BOJIT/squishbox-zero/README.md

# squishbox-zero
MIDI Synthesiser based on https://github.com/GeekFunkLabs/squishbox: adapted for Pi Zero 2W
