BOJIT/squishbox-zero/hardware/squishbox_zero.kicad_pcb

## KiCad design hardware/squishbox_zero.kicad_pcb (2025-08-31)

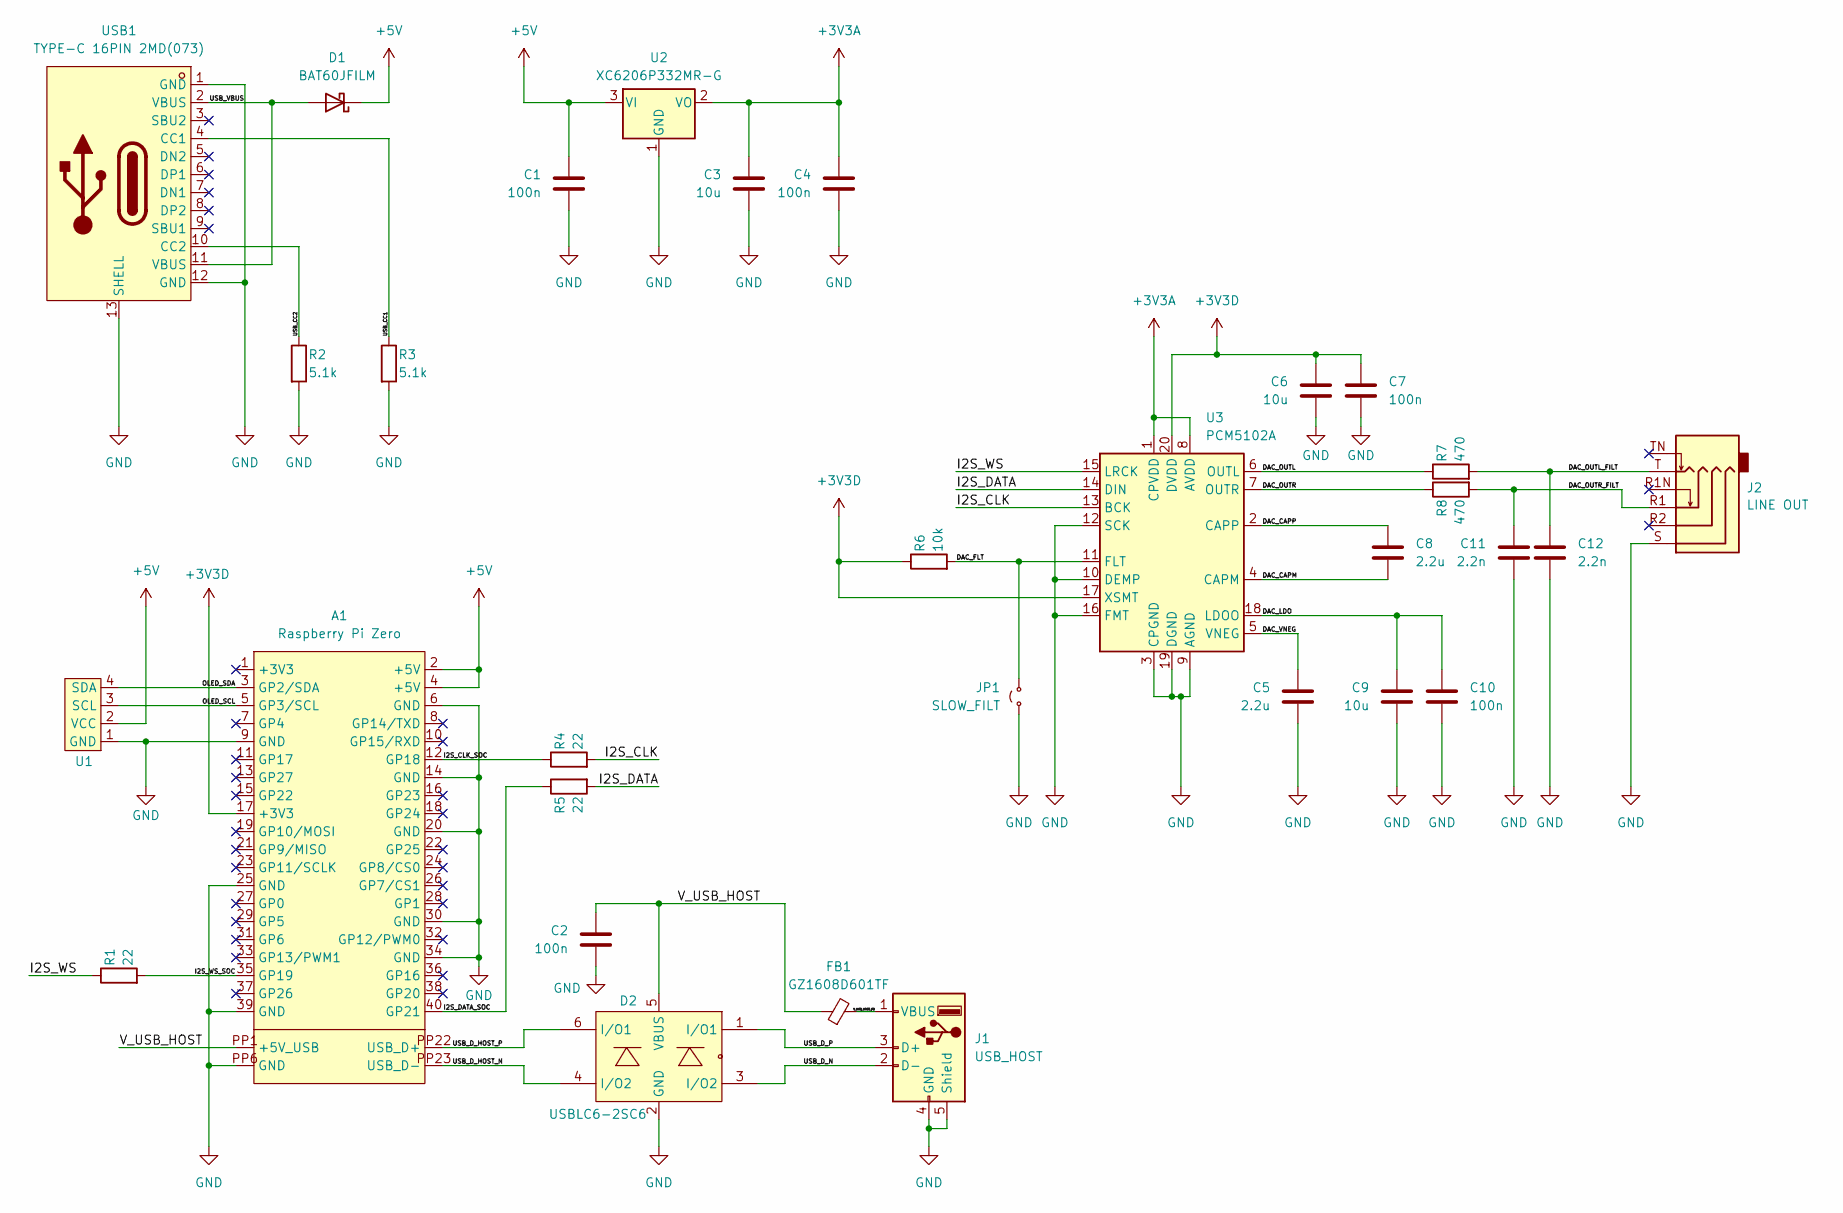
[picture p1: schematic squishbox_zero.kicad_sch]

Parts:
A1: Raspberry Pi Zero; Raspberry_Pi_Zero
C1, C2, C4, C7, C10: 100n; C_0402_1005Metric; LCSC Part C1525
C3, C6, C9: 10u; C_0603_1608Metric; LCSC Part C19702
C5, C8: 2.2u; C_0402_1005Metric; LCSC Part C12530
C11, C12: 2.2n; C_0805_2012Metric; LCSC Part C28260
D1: BAT60JFILM; D_SOD-323; LCSC Part C133103
D2: USBLC6-2SC6; SOT-23-6_L2.9-W1.6-P0.95-LS2.8-BL; LCSC Part C7519
FB1: GZ1608D601TF; R_0603_1608Metric; LCSC Part C1002
J1: USB_HOST; USB-A-SMD_USB-M-21; LCSC Part C42474
J2: LINE OUT; AUDIO-SMD_PJ-342; LCSC Part C668606
JP1: SLOW_FILT; SolderJumper-2_P1.3mm_Open_RoundedPad1.0x1.5mm
R1, R4, R5: 22; R_0402_1005Metric; LCSC Part C25092
R2, R3: 5.1k; R_0402_1005Metric; LCSC Part C25905
R6: 10k; R_0402_1005Metric; LCSC Part C25744
R7, R8: 470; R_0402_1005Metric; LCSC Part C25117
U1: SSD1306-0.91-OLED-4pin-128x32
U2: XC6206P332MR-G; SOT-23-3; LCSC Part C5446
U3: PCM5102A; TSSOP-20_4.4x6.5mm_P0.65mm; LCSC Part C107671
USB1: TYPE-C 16PIN 2MD(073); USB-C-SMD_TYPE-C-16PIN; LCSC Part C2765186

Connections:
+3V3A: C3.1, C4.1, U2.2 (VO), U3.1 (CPVDD), U3.8 (AVDD)
+3V3D: A1.17 (+3V3), C6.1, C7.1, R6.1, U3.17 (XSMT), U3.20 (DVDD)
+5V: A1.2 (+5V), A1.4 (+5V), C1.1, D1.1 (K), U1.2 (VCC), U2.3 (VI)
/DAC_CAPM: C8.2, U3.4 (CAPM)
/DAC_CAPP: C8.1, U3.2 (CAPP)
/DAC_FLT: JP1.2 (B), R6.2, U3.11 (FLT)
/DAC_LDO: C9.1, C10.1, U3.18 (LDOO)
/DAC_OUTL: R7.1, U3.6 (OUTL)
/DAC_OUTL_FILT: C12.1, J2.T, R7.2
/DAC_OUTR: R8.1, U3.7 (OUTR)
/DAC_OUTR_FILT: C11.1, J2.R1, R8.2
/DAC_VNEG: C5.1, U3.5 (VNEG)
/I2S_CLK: R4.2, U3.13 (BCK)
/I2S_CLK_SOC: A1.12 (GP18), R4.1
/I2S_DATA: R5.2, U3.14 (DIN)
/I2S_DATA_SOC: A1.40 (GP21), R5.1
/I2S_WS: R1.1, U3.15 (LRCK)
/I2S_WS_SOC: A1.35 (GP19), R1.2
/OLED_SCL: A1.5 (GP3/SCL), U1.3 (SCL)
/OLED_SDA: A1.3 (GP2/SDA), U1.4 (SDA)
/USB_CC1: R3.1, USB1.4 (CC1)
/USB_CC2: R2.1, USB1.10 (CC2)
/USB_D_HOST_N: A1.PP23 (USB_D-), D2.4 (I/O2)
/USB_D_HOST_P: A1.PP22 (USB_D+), D2.6 (I/O1)
/USB_D_N: D2.3 (I/O2), J1.2 (D-)
/USB_D_P: D2.1 (I/O1), J1.3 (D+)
/USB_VBUS: D1.2 (A), USB1.2 (VBUS), USB1.11 (VBUS)
/V_USB_HOST: A1.PP1 (+5V_USB), C2.1, D2.5 (VBUS), FB1.1
/V_USB_HOST_FB: FB1.2, J1.1 (VBUS)
GND: A1.6 (GND), A1.9 (GND), A1.14 (GND), A1.20 (GND), A1.25 (GND), A1.30 (GND), A1.34 (GND), A1.39 (GND), A1.PP6 (GND), C1.2, C2.2, C3.2, C4.2, C5.2, C6.2, C7.2, C9.2, C10.2, C11.2, C12.2, D2.2 (GND), J1.4 (GND), J1.5 (Shield), J2.S, JP1.1 (A), R2.2, R3.2, U1.1 (GND), U2.1 (GND), U3.3 (CPGND), U3.9 (AGND), U3.10 (DEMP), U3.12 (SCK), U3.16 (FMT), U3.19 (DGND), USB1.1 (GND), USB1.12 (GND), USB1.13 (SHELL)

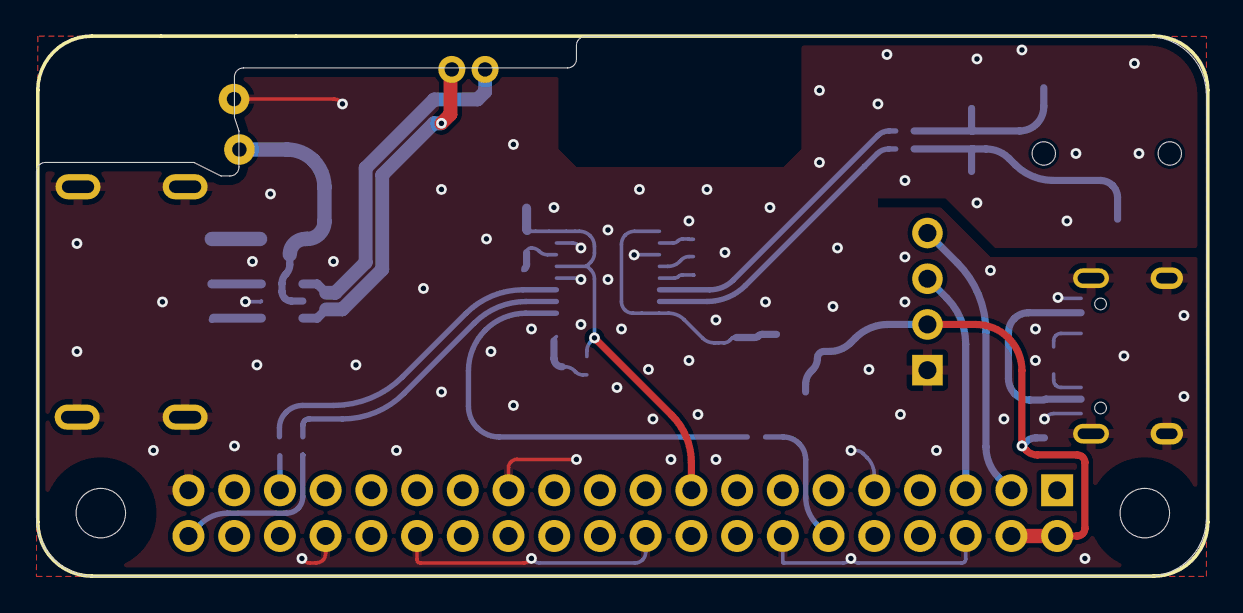
[picture p2: board squishbox_zero.kicad_pcb from above]

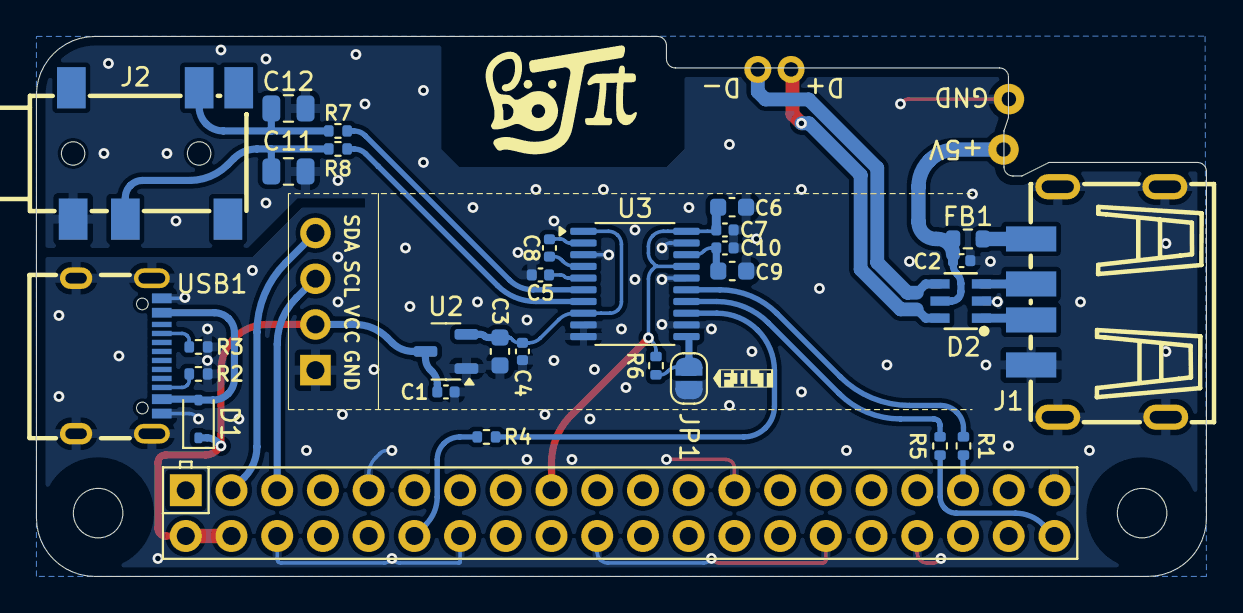
[picture p3: board squishbox_zero.kicad_pcb from below]

Board: 2 copper layers, 65.0 x 30.0 mm, 32 parts (32 on the bottom side), 30 nets.

Other parts of the board:
kibuzzard-68B38B7F: G***; kibuzzard-68B38B7F
