BOJIT/squishbox-zero/software/display.py

#!/usr/bin/env python3


"""
This demo will fill the screen with white, draw a black box on top
and then print Hello World! in the center of the display

This example is for use on (Linux) computers that are using CPython with
Adafruit Blinka to support CircuitPython libraries. CircuitPython does
not support PIL/pillow (python imaging library)!
"""

import board
import digitalio
from PIL import Image, ImageDraw, ImageFont

import adafruit_ssd1306

# Define the Reset Pin
oled_reset = digitalio.DigitalInOut(board.D4)

WIDTH = 128
HEIGHT = 32
BORDER = 5

i2c = board.I2C()  # uses board.SCL and board.SDA
oled = adafruit_ssd1306.SSD1306_I2C(WIDTH, HEIGHT, i2c, addr=0x3C, reset=oled_reset)

# Clear display.
oled.fill(0)
oled.show()


def display(text):
    # Create blank image for drawing.
    # Make sure to create image with mode '1' for 1-bit color.
    image = Image.new("1", (oled.width, oled.height))

    # Get drawing object to draw on image.
    draw = ImageDraw.Draw(image)

    # Draw a white background
    draw.rectangle((0, 0, oled.width, oled.height), outline=255, fill=255)

    # Draw a smaller inner rectangle
    draw.rectangle(
        (BORDER, BORDER, oled.width - BORDER - 1, oled.height - BORDER - 1),
        outline=0,
        fill=0,
    )

    # Load default font.
    font = ImageFont.load_default()

    # Draw Some Text
    bbox = font.getbbox(text)
    (font_width, font_height) = bbox[2] - bbox[0], bbox[3] - bbox[1]
    draw.text(
        (oled.width // 2 - font_width // 2, oled.height // 2 - font_height // 2),
        text,
        font=font,
        fill=255,
    )

    # Display image
    oled.image(image)
    oled.show()
