BOJIT/squishbox-zero/(commit log)

2025-08-30 Rough form factor in place
    [squishbox_zero.kicad_pcb, squishbox_zero.kicad_sch]
2025-08-30 Audio circuit layout
    [squishbox_zero.kicad_pcb, squishbox_zero.kicad_sch, usb.kicad_sch]
2025-08-30 LCD + Finalised Schematic
    [squishbox_zero.kicad_pcb, squishbox_zero.kicad_sch, usb.kicad_sch]
2025-08-31 First attempt at fab files
    [bom.csv, designators.csv, positions.csv, squishbox_zero.kicad_pcb, squishbox_zero.kicad_sch]
2025-08-31 Fix component orientation
    [positions.csv]
